DoctorWkt/CSCv2/Figs/cscv2_breadboard_photo.jpg

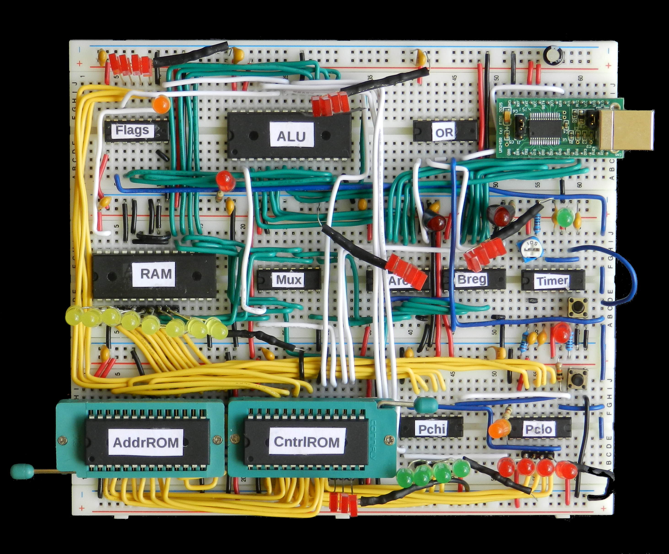
Figs/cscv2_breadboard_photo.jpg
