DoctorWkt/CSCv2/Figs/stripboard_cscv2.jpg

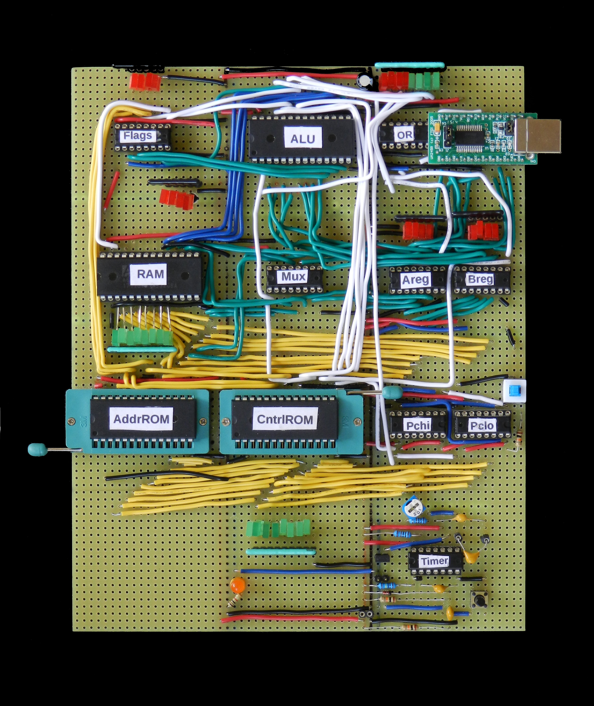
Figs/stripboard_cscv2.jpg
