DoctorWkt/CSCv2/Schematic.pdf

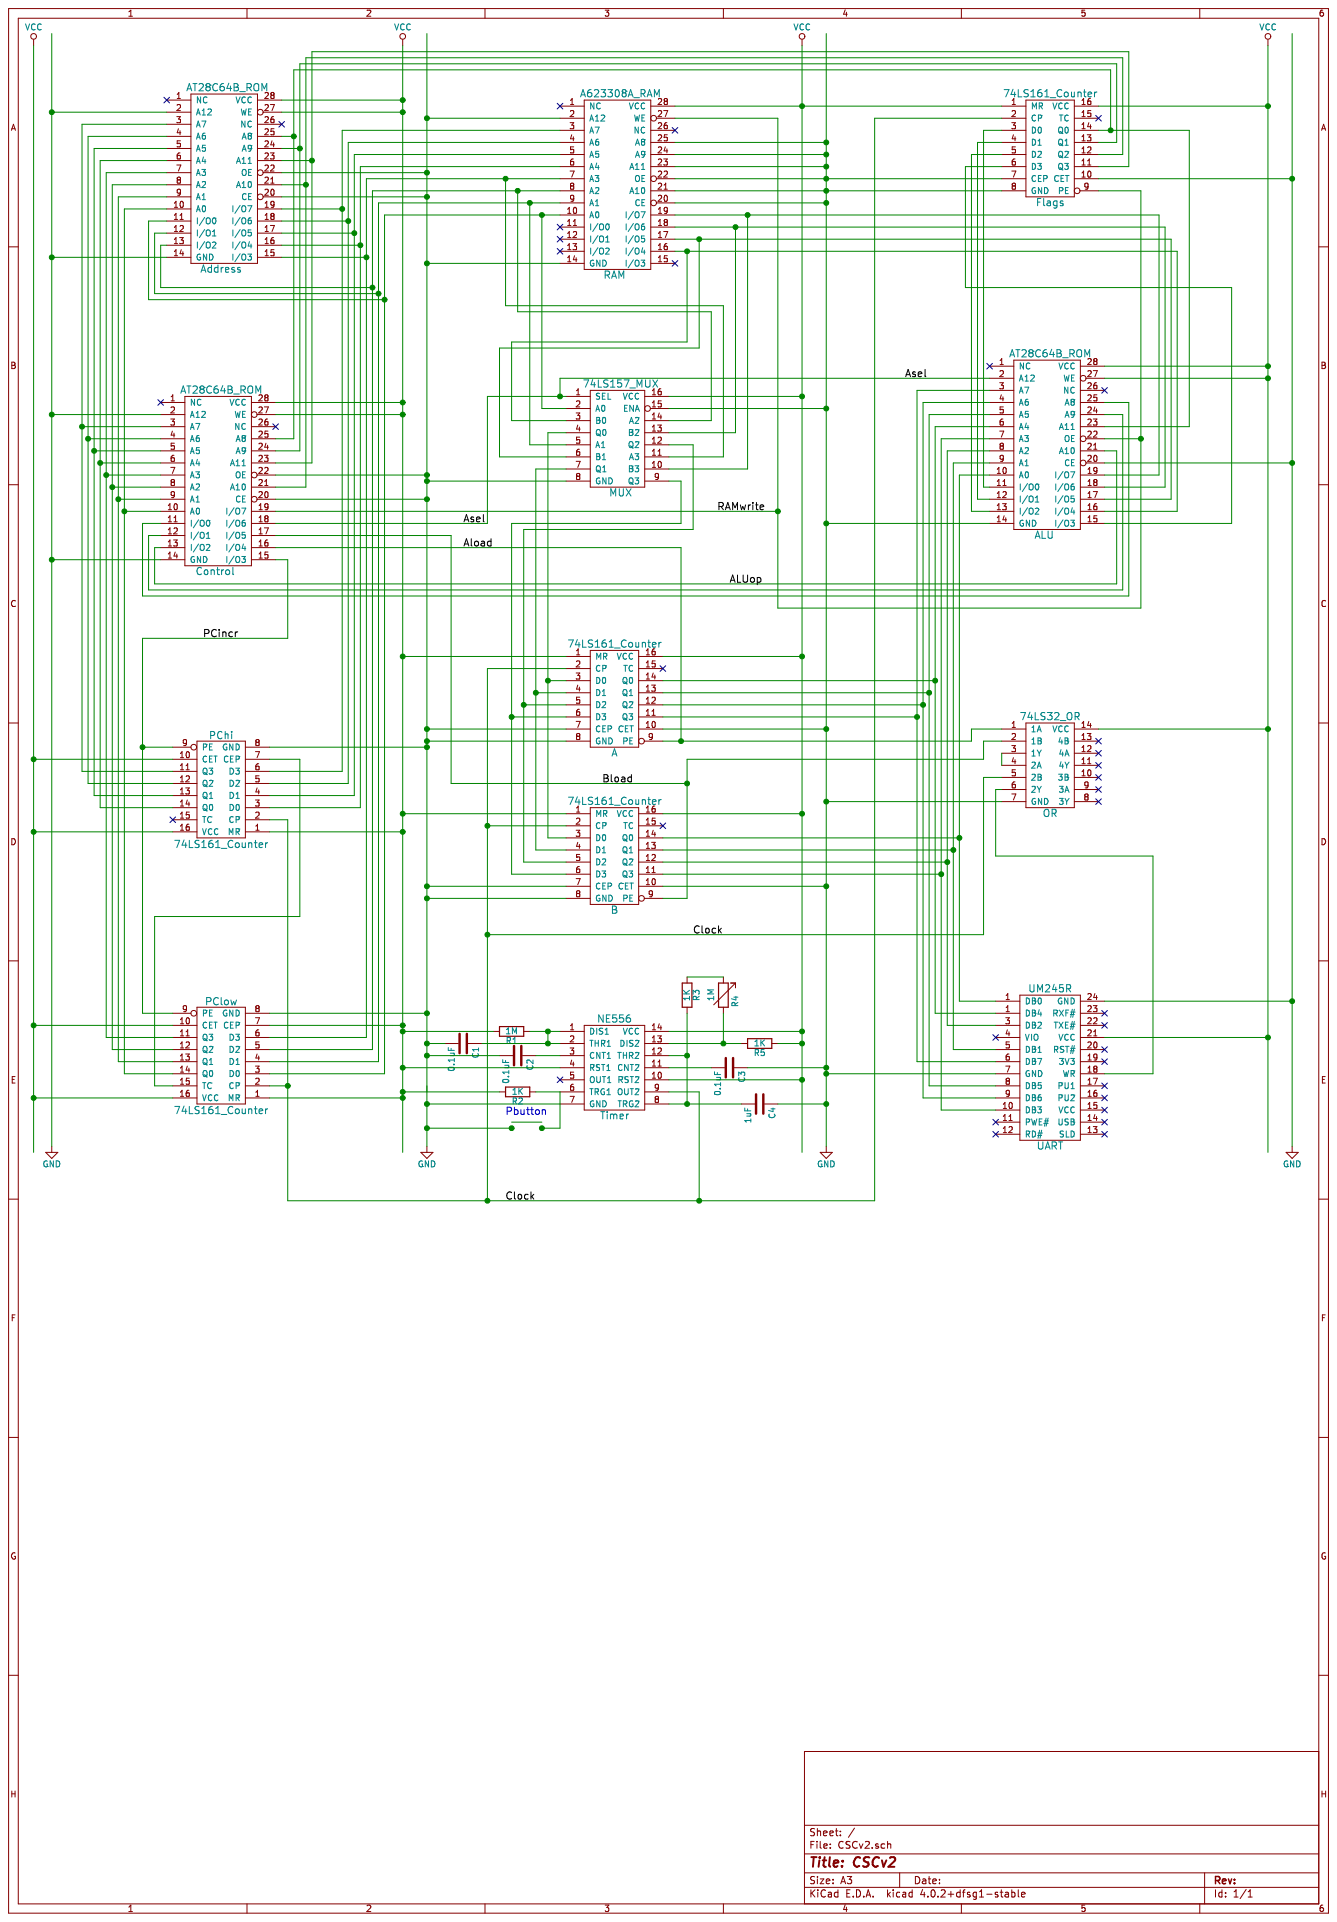
[picture p6: page 1]
