DoctorWkt/CSCv2/(list of files, drawings)

Other design files:
crazycpu.circ
