DoctorWkt/CSCv2/(commit log)

2017-10-10 Import of files from version 1 of the CSC
    How about I actually import the files? :-)
    [crazycpu.circ]
2017-10-11 First attempt at adding the new ALU operations
    I've modified everything to have the new wiring and the new ALU
    operations. fibminsky still runs, which is a good sign.
    [crazycpu.circ]
2017-10-11 Updated schematic of the CPU
    I've included a schematic of the CPU with the new wire from
    the Asel output on the top ROM to the A12 line on the ALU ROM.
2017-10-11 Added fibminsky.s program
    [crazycpu.circ]
2017-10-11 Fixed CLC bug in the assembler
    I noticed that fibminsky stopped working. It was my change to
    the CLC control lines. I've reverted to the old set of control lines,
    but I should work out why it isn't working with the new ones.
2017-10-11 Fixed typo in cas assembler
    I had a typo on the definition of ZERO, so the new CLC
    which uses ALUzero was not right. Now Fixed.
2017-10-11 Forgot to update crazycpu.circ with the fixed cas output
    It's now fixed and runs fibminsky.
    [crazycpu.circ]
2017-10-12 Wiring mistake in schematic fixed
    Chris Baird found it.
2017-10-12 Bug in Examples/printhex.s fixed
    I forgot that I needed to clear the carry.
2017-10-12 Decimal printing works!
    I came up with a kludgy way to print an 8-bit value
    out in decimal as three ASCII characters. I've also
    used it to print a circle out using Minsky's circle
    algorithm and VT100 escape sequences.
2017-10-12 Clock rate option to csim
    I added a simulated clock rate to csim: csim -d 1000
    simulates a 1000 Hz clock rate. Not very accurate though.
2017-10-12 Updated the printhex code with the CLC which is needed
2017-10-14 Yet another example program: Examples/enumttt.s
    This program enumerates the winning tic tac toe boards
    where X makes the first move. It really was hard to
    squeeze the program in to the instruction space.
2017-10-23 Bug fixes for clc
    I perused the clc source code and found a couple of bugs to fix.
2017-10-25 Fixed bug in debug output in csim
    I was printing out the wrong ALU operation, now fixed.
2017-10-26 Even more optimisation: a way to print out two hex digits in 9 instructions
2017-10-26 Added hex printing functionality to the compiler
    Now that there's a way to print two hex digits in 9 instructions, I
    thought it was cheap enough to add to the compiler.
2017-11-05 New schematic plus updated notes
    I redrew the schematic so that the UART and the two 74LS161 PC
    chips are properly on the one schematic.
2017-11-06 Wire mistake fixed on schematic
    I had the Flags /PE line wired low always. I'm sure this should be
    wired to RAMwrite, so that the register is only updated when there
    is an ALU operation written to RAM. The csim simulator has this
    behaviour, too.
2017-11-09 Removed redundant flags code from clc
    Now that we don't have to explicitly write the NZVC flags combinations
    in the assembler, I removed the code to write this out in the compiler.
2017-11-11 Updated schematic
    I updated the schematic to include the clock signal going to the UART
    control, and renamed a few files.
2017-11-11 Oops, another schematic mistake fixed
2017-11-18 Added single-stepping to csim
    I've added quite a lot of new functionality to cas and csim. There are
    three new pseudo-instructions which are NOPs in real hardware. BRK drops
    into single-step mode. DBG prints out the registers. DMP prints out all
    the RAM values.
    In single-step mode, you can set and delete further breakpoints, single-step,
    continue, prints out the registers and print out all the RAM values. There
    is also a cmd-line option to csim to set a breakpoint even in a program
    that doesn't have a BRK instruction. I've used this to really help me debug
    my own life program.
2017-12-13 More notes, fixed a few schematic errors
2018-01-03 Imported the Verilog version which I've been working on
    This now works with Icarus and Verilator, and the design can
    be synthesized with the IceStorm toolchain to run on the
    TinyFPGA B2 device.
2018-11-24 I had a N-flag bug which I fixed as well as cleaning up the ALU code.
    [alu.v, ram.v]
2018-12-02 Added support for the ULX3S FPGA board.
2018-12-02 Change ULX3S to ensure UART output. The CPU was running slightly too fast for the UART to keep up, so I halved the CPU's clock rate.
    [ULX3S.v]
